nas256/ece3400_team13/README.md

# ece3400_team13

Welcome to team Lucky 13's Github repo!
