nas256/ece3400_team13/Final_Design/finaldesign_home.md

# Final Robot Design
 
<!--![Front Shot](https://i.imgur.com/Rkkye7J.jpg)-->

This section will summarize our final design and describe our additions to the design after completing the labs and milestones.

## Overview

<!---![Roboto](https://i.imgur.com/7y2TJ4C.jpg)-->

 - [Addition of a PCB](https://nas256.github.io/ece3400_team13/Final_Design/PCB)
 - [Depth First Search Algorithm](https://nas256.github.io/ece3400_team13/Final_Design/DFS)
 - [IR Sensing](https://nas256.github.io/ece3400_team13/Final_Design/IR_sensing)
 - [Wall Sensing](https://nas256.github.io/ece3400_team13/Final_Design/Wall_Sensing)
 - [Line Following](https://nas256.github.io/ece3400_team13/Final_Design/Line_Following)
 - [Servos](https://nas256.github.io/ece3400_team13/Final_Design/Servos)
 - [Starting Logic](https://nas256.github.io/ece3400_team13/Final_Design/Start_Logic)
 - [Analog Mux](https://nas256.github.io/ece3400_team13/Final_Design/Mux)
 - [RF Comm](https://nas256.github.io/ece3400_team13/Final_Design/RF)
 - [Base Station](https://nas256.github.io/ece3400_team13/Final_Design/Base_Station)

### Robot System Design

Robot System

### BaseStation System Design

BaseStation System

BaseStation IRL

## Cost Breakdown

| Part | Indv Cost | Quantity | Total Cost |
|:---:|---|:---:|:---:|
| Line Sensors | $3 | 4 | $12 |
| Wall Sensors | $7 | 3 | $21 |
| Servos | $13 | 2 | $26 |
| LM358 | $0.95 | 1 | $0.95 |
| 3D printed parts  | N/A | 10 | $0 |
| Lazer cut chassis | N/A | 1 | $0 |
| Custom PCB | $10 | 1 | $10 |
| Ball Bearing | N/A | 1 | $0 |
| Photo Transistor  | $0.51 | 2 | $1.02 |
| Mux | $0.43 | 1 | $0.43 |
| Microphone | $7 | 1 | $7 |
| 5V Battery Pack | N/A | 1 | $0 |
| 9V Battery | N/A | 1 | $0 |
| **Total** | | | $78.41 |
