nas256/ece3400_team13/minutes/10-20-2017.md

## Meeting Minutes 10-20-2017
Everyone in attendance

### Status:
- Wireless Team
  - Got transmission working
  - Got receiving working
  - Transmitting and receiving fake maze packets

- Visual Team
  - Specified SPI protocol and switched over to it
  - Add support for explored, unexplored, and current location
  - Created arduino program to simulate a robot movement

- Combination
  - Correctly sent and received packets
  - Able to update a single tile on the screen
  - **TODO**: Use Eric's Arduino simulation but implement wirelessly
