nas256/ece3400_team13/minutes/9-22-2017.md

## Meeting Minutes 9-22-2017

### Goals:
    -Incorporate mux to select between analog inputs
    -Put IR sensors on robot

### Misc.
    -Switching to GoogleDocs for writing report

Meet either Saturday or early next week
