nas256/ece3400_team13/minutes/9-8-2017.md

## Meeting Minutes 9/8/2017

 - Lab2: The analog circuit is not worth it, just focus on using FFTs
    - Next lab we'll split into two groups, last lab we got basic line following and turning on a grid working, as well as the Lab 2 prelab and starting the analog circuitry
 - Regular meeting time: Friday 5-6:30pm
 - Choosing a motor
    - QUAD H-bridge 4A total (drive two motors): https://www.sparkfun.com/products/315
    - Dual Motor Driver (Polulu): https://www.pololu.com/product/2135
    - Micro Metal 6V 75RM 700mA max motor: https://www.pololu.com/product/237
