nas256/ece3400_team13/Lab4Photos/IMG_20171019_203245.jpg

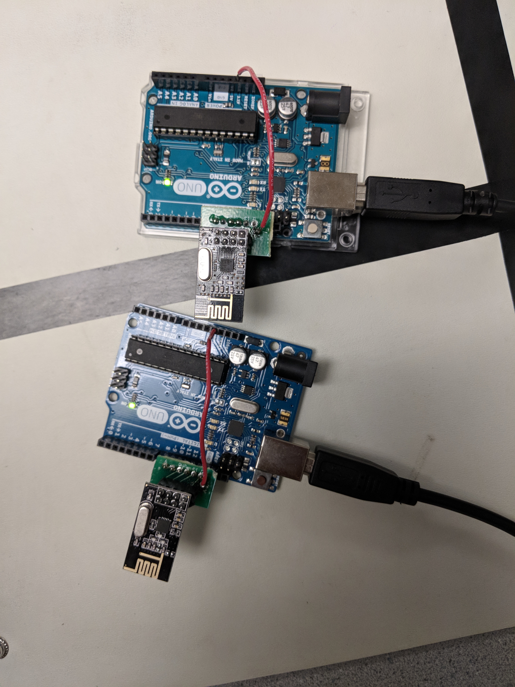
Lab4Photos/IMG_20171019_203245.jpg
