nas256/ece3400_team13/(commit log)

2017-09-01 Team Contract: Insert line breaks in signature area
2017-09-02 Lab1: Add 'Driving Servo with Potentiometer' section
2017-09-02 Add 'Soldering' section
2017-09-05 Driving Servo with Pot: Use YouTube video instead
2017-09-05 Drive Servo with Pot: Fix images
2017-09-05 Added description about making internal LED blink
2017-09-07 Fixed servo pwm arguments
2017-09-07 added robot assembly section
2017-09-07 Fixed typos in section: Assembling robot
2017-09-08 added picture of assembled robot
2017-09-20 Add circuit diagram and explanation
2017-09-20 Added section: Opamp Circuit
2017-09-20 Update lab2.md
    Distinguish 660Hz
2017-09-21 Added microphone fft picture in section: FFT & Arduino
2017-09-29 Added milestone 2 optical LED video, description
2017-10-18 Add a bit of the visual verilog/spi section
2017-10-18 Add SPI waveforms
2017-10-18 Messed up spi table
2017-10-19 Add to the arduino section
2017-10-19 Add voltage divider section to arduino
2017-10-20 Added stereo jack socket pic
2017-10-20 Proofread Lab3 report graphics section, below SPI Protocol
2017-10-25 Wireless Communication
2017-10-25 lab4: describe updated SPI protocol
2017-10-27 added arduino code
2017-12-03 Finish PCB page
2017-12-03 Add back buttons
2017-12-03 added flow charts
2017-12-04 added schematic
2017-12-05 added paragraph about optoisolators on the servos
2017-12-05 added one more sentence to Servos
2017-12-06 added outline for servos
2017-12-06 added schematic pics and datasheet hyperlinks
